Reenforcements/WirelessMicrophone/links.rtf

Github:
https://github.com/Reenforcements/WirelessMicrophone
Digital potentiometer/datasheet:
http://www.microchip.com/wwwproducts/en/MCP4151
https://www.mouser.com/datasheet/2/268/22060a-53835.pdf
Arduino Nano pinout:
https://forum.arduino.cc/index.php?topic=147582.0
SPI Library:
https://www.arduino.cc/en/Reference/SPI
ATMega 328p Datasheet:
http://ww1.microchip.com/downloads/en/DeviceDoc/Atmel-42735-8-bit-AVR-Microcontroller-ATmega328-328P_Datasheet.pdf
OP AMP:
http://www.ti.com/lit/ds/symlink/lm358-n.pdf
