Reenforcements/WirelessMicrophone/ReadmeContent/ReadmeOutline.rtf

• Overview
• Background
⁃ What is audio
⁃
• How to use
⁃ Video of it working
• How it works
• Acknowledgements
⁃ Libraries used
