Reenforcements/WirelessMicrophone/ReadmeContent/ReceivingPhoto.jpg

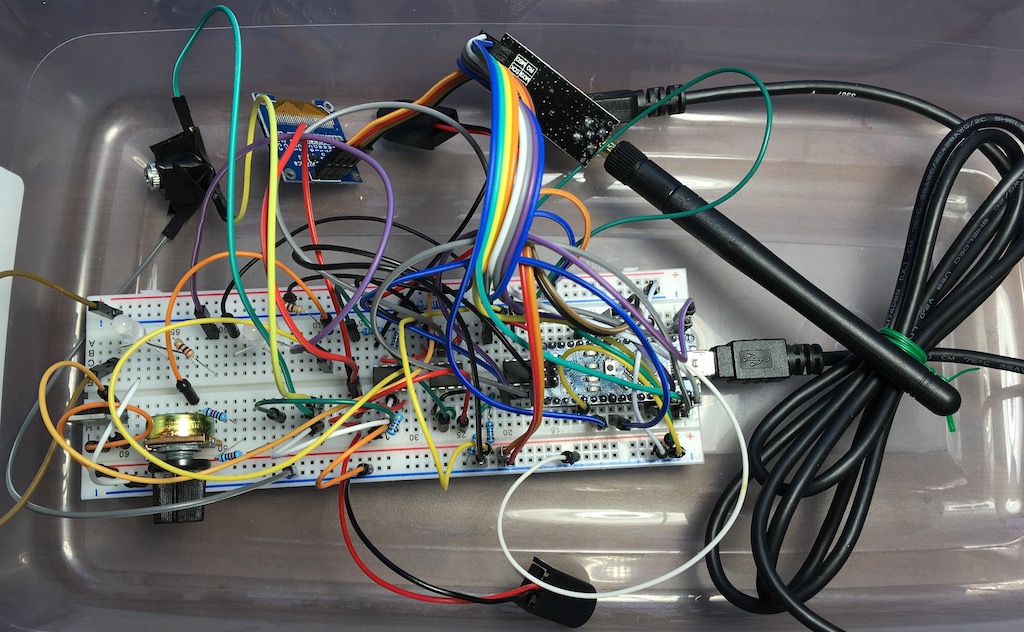
ReadmeContent/ReceivingPhoto.jpg
