Reenforcements/WirelessMicrophone/ReadmeContent/SendingScreenshot.png

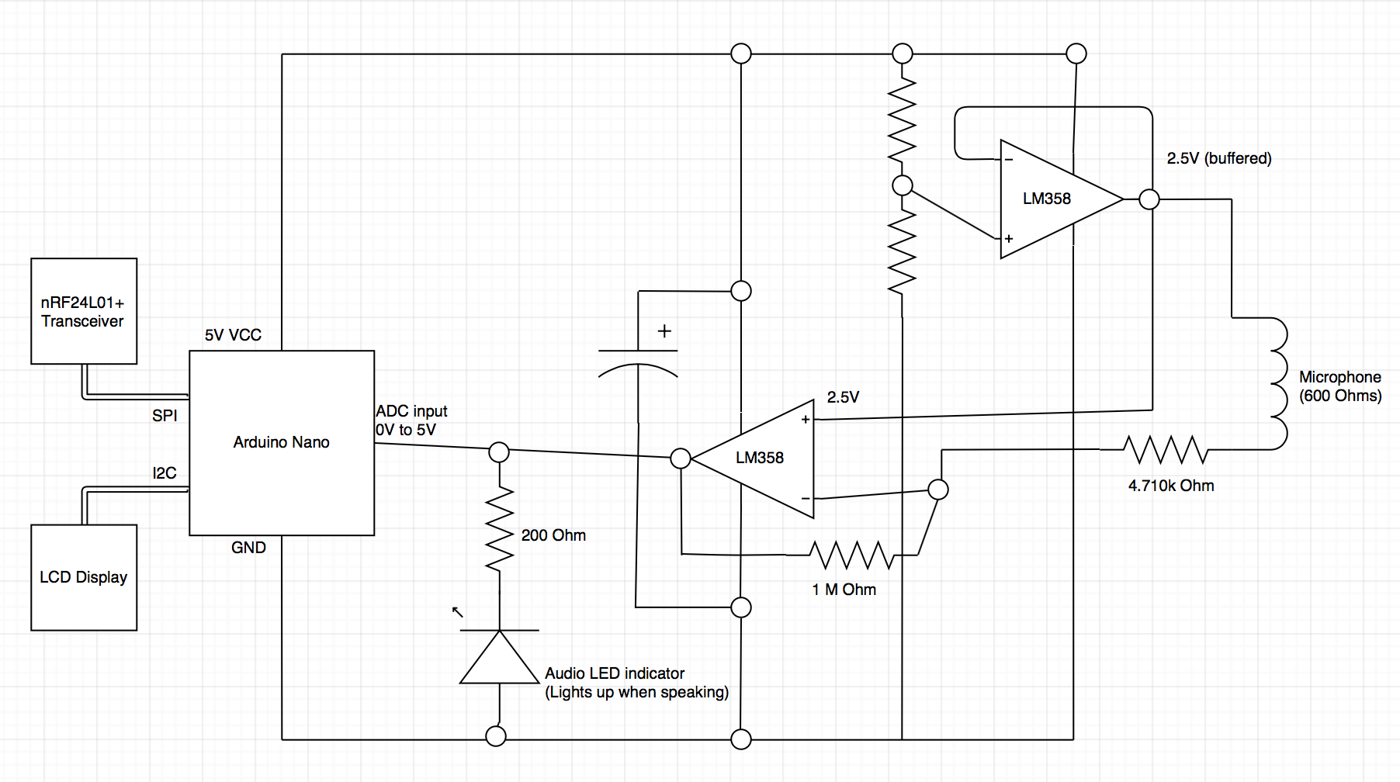
ReadmeContent/SendingScreenshot.png
