Reenforcements/WirelessMicrophone/(commit log)

2018-04-16 Initial commit
    -Other test projects
    -Sender/Receiver code related to my library sample code that I'm going to work off of.
    -links.txt with important links for me (and anyone else)
2018-04-16 Datarate has been reached!
    45920 samples (bytes) being sent a second! That's plenty.
